tommycoolman/Mustang-Android-Head-Unit-Install/README.md

This is a guide for installing an Android Head unit into a 2017 Ford Mustang GT.
