tommycoolman/Mustang-Android-Head-Unit-Install/3D Print - Andoid Head Unit Support.stl

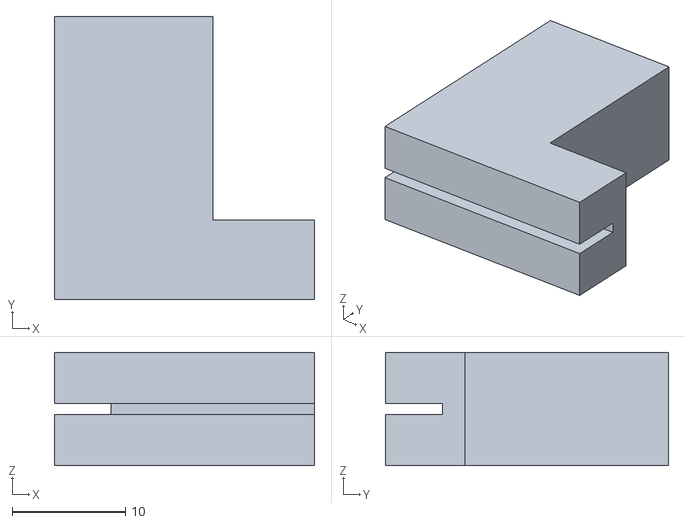
[picture p1: CAD file, 2025-10-26]
3D Print - Andoid Head Unit Support.stl
23.0 x 25.0 x 10.0
