tommycoolman/Mustang-Android-Head-Unit-Install/3D Print - Microphone Holder.stl

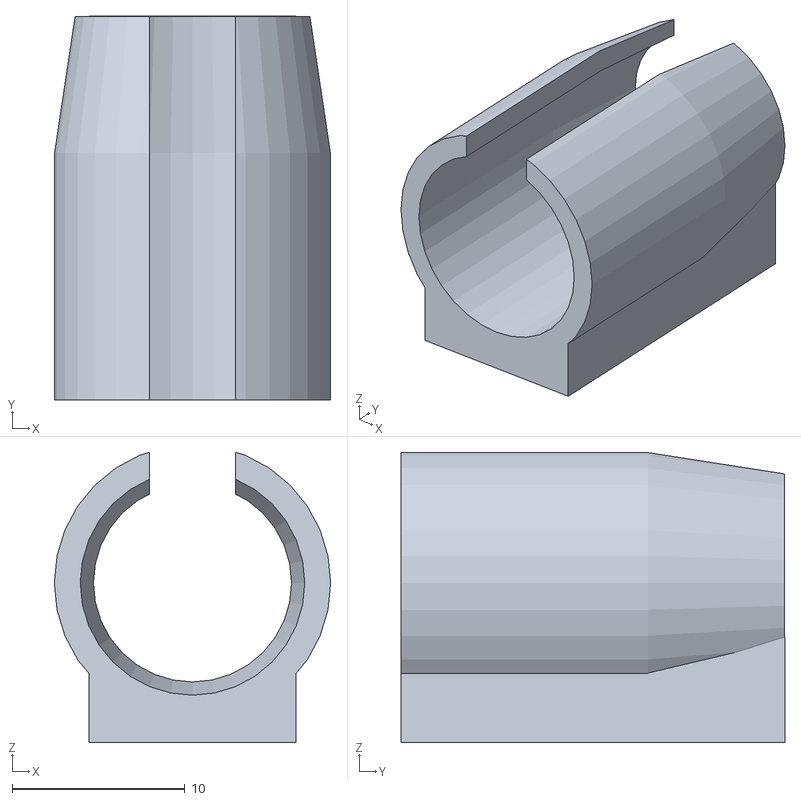
[picture p2: CAD file, 2025-09-13]
3D Print - Microphone Holder.stl
16.0 x 22.2 x 16.8
