tommycoolman/Mustang-Android-Head-Unit-Install/(commit log)

2025-09-13 Add files via upload
    STL file for 3D printing a microphone holder.
    [Microphone Holder.stl]
2025-09-19 Add files via upload
    Bracket to keep the back of the head unit in place.
    [Andoid Head Unit Bracket.stl]
2025-10-26 Rename Andoid Head Unit Bracket.stl to 3D Print - Andoid Head Unit Bracket.stl
    [3D Print - Andoid Head Unit Bracket.stl]
2025-10-26 Rename Microphone Holder.stl to 3D Print - Microphone Holder.stl
    [3D Print - Microphone Holder.stl]
2025-10-26 Rename 3D Print - Andoid Head Unit Bracket.stl to 3D Print - Andoid Head Unit Support.stl
    [3D Print - Andoid Head Unit Support.stl]
